ad-johnson/YAPS/README.md

# YAPS
Bench top power supply

Schematics are in the Design folder

Custom footprints and symbols are in the Kicad folder: these will need downloading and their location added into the Kicad project's preferences: add location to Manage Symbol Libraries and Manage Footprint Libraries

LTSpice files are in the LTSpice file.  They are broken down into three parts: Power Stage; Control Stage and Combined.  AndrewsParts may need to be put into your LTSpice installation sym library, e.g. ~/Library/ApplicationSupport/LTSpice/lib/sym
