ad-johnson/YAPS/Design/Other/BOM.xlsx

Name | Type | Ref - Control Stage | Ref - Power Stage | Reqd Qty | Order Qty | Mounting | Mfr | Mfr Part No. | Farnell Code | Digikey Code | CPC Code | Mouser Code | Datasheet | Notes
0.1uF | Capacitor | C2, C7 |  | 2 | 10 | 0805 | Multicomp | MC0805B104J500CT | 2320839 |  |  |  | Datasheet (http://www.farnell.com/datasheets/1901289.pdf)
100uF | Electrolytic | C1, C10 |  | 2 | 2 | 8x10 SMD | Nichicon | UUD1H101MNL1GS | 8823391 |  |  |  | Datasheet (http://www.farnell.com/datasheets/2100017.pdf)
6-way receptacle | CONNECTOR | J3, J6 |  | 2 | 2 | N/A | Molex | 22-01-2061 |  | WM1579-ND |  |  | Datasheet (https://www.molex.com/pdm_docs/sd/022012061_sd.pdf)
6-way header | CONNECTOR | J3, J6 |  | 2 | 2 | TH | Molex | 22-27-2061 |  | WM4115-ND |  |  | Datasheet (https://www.molex.com/pdm_docs/sd/022272061_sd.pdf)
2-way receptacle | CONNECTOR | J1 |  | 1 | 1 | N/A | Molex | 22-01-2021 |  | WM1575-ND |  |  | Datasheet (https://www.molex.com/pdm_docs/sd/022012021_sd.pdf)
2-way header | CONNECTOR | J1 |  | 1 | 1 | TH | Molex | 22-27-2021 |  | WM4111-ND |  |  | Datasheet (https://www.molex.com/pdm_docs/sd/022272021_sd.pdf)
8-way receptacle | CONNECTOR | J4 |  | 1 | 1 | N/A | Molex | 22-01-2081 |  | WM1581-ND |  |  | Datasheet (https://www.molex.com/pdm_docs/sd/022012081_sd.pdf)
8-way header | CONNECTOR | J4 |  | 1 | 1 | TH | Molex | 22-27-2081 |  | WM4117-ND |  |  | Datasheet (https://www.molex.com/pdm_docs/sd/022272081_sd.pdf)
Crimp | CONNECTOR | J1, J3, J4, J6 |  | 4 | 25 | N/A | Molex | 08-50-0032 |  | WM2623-ND |  |  | Datasheet (https://www.molex.com/pdm_docs/ps/PS-99020-0088.pdf)
Current Source LT3092 | IC | U2 |  | 1 | 1 | SOT223 | Linear Technology | LT3092EST#TRPBF |  | LT3092EST#TRPBFCT-ND |  |  | Datasheet (http://www.linear.com/docs/27892)
Step Down Reg LTC1624 | IC | U1 |  | 1 | 1 | 8-SOIC | Linear Technology | LTC1624CS8#PBF |  | LTC1624CS8#PBF-ND |  |  | Datasheet (http://www.linear.com/docs/3645)
Linear Reg LT3081 | IC | U3, U4 |  | 2 | 2 | TO-220-7 | Linear Technology | LT3081ET7#PBF |  | LT3081ET7#PBF-ND |  |  | Datasheet (http://www.linear.com/docs/43256)
Switched Inv LTC1983-2 | IC | U5 |  | 1 | 1 | SOT226 | Linear Technology | LTC1983ES6-3#TRPBF |  | LTC1983ES6-3#TRPBFCT-ND |  |  | Datasheet (http://www.linear.com/docs/2135)
Pwr/Curr Monitor INA260 | IC | U6 |  | 1 | 1 | 16-TSSOP | TI | INA260AIPWR |  | 296-47777-1-ND |  |  | Datasheet (http://www.ti.com/general/docs/suppproductinfo.tsp?distId=10)
DC-DC Linear Converter 5V 1A | REGULATOR | U7 |  | 1 | 1 | SIP/TO-220 | Traco Power | TSRN 1-2450 | 2280247 |  |  |  | Datasheet (https://docs-emea.rs-online.com/webdocs/16ed/0900766b816ed3dd.pdf) | TSR 1-2450 also acceptable
470pF | Capacitor | C3 |  | 1 | 10 | 0805 | Vishay | VJ0805Y471JXAPW1BC | 2896583 |  |  |  | Datasheet (http://www.farnell.com/datasheets/2620235.pdf)
100pF | Capacitor | C4 |  | 1 | 10 | 0805 | Kemet | C0805C101J5RACAUTO | 2905173 |  |  |  | Datasheet (http://www.farnell.com/datasheets/2750056.pdf)
1000pF | Capacitor | C6, C8, C9 |  | 3 | 10 | 0805 | Multicomp | MC0805B102J500CT | 2320837 |  |  |  | Datasheet (http://www.farnell.com/datasheets/1901289.pdf)
10uF | Capacitor | C11, C12, C13, C14, C15, C17, C18, C19, C20, C21, C22, C23, C25 |  | 13 | 20 | 0805 | Murata | GRM21BR6YA106KE43L | 2611943 |  |  |  | Datasheet (http://www.farnell.com/datasheets/2079187.pdf)
1uF | Capacitor | C24, C26 |  | 2 | 5 | 0805 | Murata | GCM21BR71H105KA03L | 2688485 |  |  |  | Datasheet (http://www.farnell.com/datasheets/2189091.pdf)
6K8 | Resistor | R1 |  | 1 | 10 | 0805 | Multicomp | MCWR08X6801FTL | 2447711 |  |  |  | Datasheet (http://www.farnell.com/datasheets/2563624.pdf)
10m | Resistor | R2 |  | 1 | 5 | 0805 | Samsung | RU2012FR010CS |  | 1276-6156-1-ND |  |  | Datasheet (http://www.samsungsem.com/kr/support/product-search/chip-resistor/RU2012FR010CS.jsp)
1K | Resistor | R3, R10, R11 |  | 3 | 10 | 0805 | Multicomp | MCWR08X1001FTL | 2447587 |  |  |  | Datasheet (http://www.farnell.com/datasheets/2563624.pdf)
5K | Resistor | R4 |  | 1 | 10 | 0805 | Vishay | CRCW08055K00FKTA | 2616759 |  |  |  | Datasheet (http://www.farnell.com/datasheets/2310790.pdf)
100K | Resistor | R5, R6 |  | 2 | 10 | 0805 | Multicomp | MCWR08X1003FTL | 2447551 |  |  |  | Datasheet (http://www.farnell.com/datasheets/2563624.pdf)
200 | Resistor | R7 |  | 1 | 10 | 0805 | Multicomp | MCWR08X2000FTL | 2447602 |  |  |  | Datasheet (http://www.farnell.com/datasheets/2563624.pdf)
47K5 | Resistor | R8 |  | 1 | 10 | 0805 | Multicomp | MCWR08X4752FTL | 2447665 |  |  |  | Datasheet (http://www.farnell.com/datasheets/2563624.pdf)
73K2 | Resistor | R9 |  | 1 | 10 | 0805 | Panasonic | ERJ6ENF7322V | 2303742 |  |  |  | Datasheet (http://www.farnell.com/datasheets/1911175.pdf)
1K 1% | Resistor | - |  |  | 0 | 0805 |  |  |  |  |  |  | Datasheet (http://www.farnell.com/datasheets/2563624.pdf) | See 1K resistor which is 1%
10K 1% | Resistor | R12, R13, R16, R17, R23, R24, R25 |  | 7 | 10 | 0805 | Multicomp | MCWF08P1002FTL | 2694096 |  |  |  | Datasheet (http://www.farnell.com/datasheets/2189453.pdf)
3K3 | Resistor | R14 |  | 1 | 10 | 0805 | Vishay | CRCW08053K30FKEA | 1469911 |  |  |  | Datasheet (http://www.farnell.com/datasheets/2310790.pdf)
100 | Resistor | R15 |  | 1 | 10 | 0805 | Multicomp | MCWR08X1000FTL | 2447552 |  |  |  | Datasheet (http://www.farnell.com/datasheets/2563624.pdf)
10K | Resistor | - |  |  | 0 | 0805 |  |  |  |  |  |  | Datasheet | See 10K resistor which is 1%
15m 1% | Resistor | R18, R19 |  | 2 | 5 | 0805 | Panasonic | ERJ-6CWFR015V |  | P19200CT-ND |  |  | Datasheet (https://industrial.panasonic.com/cdbs/www-data/pdf/RDN0000/AOA0000C313.pdf)
220 | Resistor | R20 |  | 1 | 10 | 0805 | Multicomp | MCWR08X2200FTL | 2447606 |  |  |  | Datasheet (http://www.farnell.com/datasheets/2563624.pdf)
2K2 | Resistor | R21, R22 |  | 2 | 10 | 0805 | Multicomp | MCWR08X2201FTL | 2447623 |  |  |  | Datasheet (http://www.farnell.com/datasheets/2563624.pdf)
Schottky Rectifier | RECTIFIER | D1, D2 |  | 2 | 5 | SMC - 2 Lead | ON Semiconductor | MBRS340T3G | 9557377 |  |  |  | Datasheet (http://www.farnell.com/datasheets/2353896.pdf)
NPN Mosfet | MOSFET | Q1 |  | 1 | 5 | TO-220 | Infineon | IRF3205PBF | 1704017 |  |  |  | Datasheet (http://www.farnell.com/datasheets/2043115.pdf)
2N3906 PNP Bipolar | TRANSISTOR | Q2 |  | 1 | 5 | TO-92 | On Semiconductor | 2N3906TA | 2453753 |  |  |  | Datasheet (https://www.onsemi.com/pub/Collateral/2N3906-D.PDF)
10uH Inductor | INDUCTOR | L1 |  | 1 | 1 | SMD Lead Frame | Bourns | SRP1265A-100M | 2434072 |  |  |  | Datasheet (http://www.farnell.com/datasheets/2366823.pdf)
2N3904 NPN Bipolar | TRANSISTOR | Q3 |  | 1 | 5 | TO-92 | On Semiconductor | 2N3904BU | 1700648 |  |  |  | Datasheet (http://www.farnell.com/datasheets/2284140.pdf)
10000pF | Capacitor | C16 |  | 1 | 10 | 0805 | Multicomp | MCU0805R103KCT | 9406352 |  |  |  | Datasheet (http://www.farnell.com/datasheets/1859359.pdf)
10K 10 Turn Potentiometer | POTENTIOMETER | Enclosure |  | 1 | 1 | Panel | Bourns | 3590S-1-103L |  | 3590S-1-103L-ND |  |  | Datasheet (https://www.bourns.com/docs/Product-Datasheets/3590.pdf)
5K 10 Turn Potentiometer | POTENTIOMETER | Enclosure |  | 1 | 1 | Panel | Bourns | 3590S-1-502L |  | 3590S-1-502L-ND |  |  | Datasheet (https://www.bourns.com/docs/Product-Datasheets/3590.pdf)
Rotary Dial | KNOB | Enclosure |  | 2 | 2 | N/A | Bourns | HH-516-6A |  | HH-516-6A-ND |  |  | Datasheet (https://www.bourns.com/docs/Product-Datasheets/H-516.pdf)
Red Binding Post | CONNECTOR | Enclosure |  | 1 | 1 | Panel | Cliff Electronic Components | TP1 Red | 1815818 |  |  |  | Datasheet (http://www.farnell.com/datasheets/1712124.pdf)
Black Binding Post | CONNECTOR | Enclosure |  | 1 | 1 | Panel | Cliff Electronic Components | TP1 Black | 1815819 |  |  |  | Datasheet (http://www.farnell.com/datasheets/1712124.pdf)
10R 100W Power Resistor | Resistor | OPTIONAL FOR TESTING |  | 0 | 1 | N/A | CGS-TE Connectivity | HSC10010RJ |  |  | RE03534 |  | Datasheet (http://www.farnell.com/datasheets/463742.pdf)
SPDT Switch | SPDT | Enclosure |  | 1 | 1 | Panel | E-Switch | RR3130CBLKBLKFS |  | EG1891-ND |  |  | Datasheet (https://www.e-switch.com/system/asset/product_line/data_sheet/94/RR3130.pdf)
60VA 9-0-9 3.3A | TRANSFORMER |  | Enclosure | 1 | 1 | Panel | Multicomp | MCTA060/09 |  |  | FF01551 |  | Datasheet (http://www.farnell.com/datasheets/1945759.pdf)
Terminal Block, 2-way | CONNECTOR | J2, J5 | J1, J2 | 4 | 4 |  | Phoenix Contact | 1729128 |  |  | CN14697 |  | Datasheet (http://www.farnell.com/datasheets/2793337.pdf)
Bridge Rectifier | RECTIFIER |  | D1 | 1 | 1 | TH | Taiwan Semiconductor | GBU603 |  |  | SC09284 |  | Datasheet (http://www.farnell.com/datasheets/41665.pdf)
Smoothing Capacitor | Capacitor |  | C1, C2 | 2 | 2 | TH | Multicomp | LPR50V478M30X25 |  |  | CA04834 |  | Datasheet (http://www.farnell.com/datasheets/1441585.pdf)
Bleed Resistor | Resistor |  | R1 | 1 | 10 | TH | TT Electronics | MFP1-10K JI |  |  | RE05119 |  | Datasheet (http://www.farnell.com/datasheets/40613.pdf)
Slow blow Fuse | FUSE |  | Enclosure | 1 | 10 | N/A | Littelfuse | 021502.5P |  |  | FF02710 |  | Datasheet (http://www.farnell.com/datasheets/2290195.pdf)
Switch&plug | CONNECTOR |  | Enclosure | 1 | 1 | Panel | Bulgin | BZH01/Z0000/01 |  |  | CN01731 |  | Datasheet
Mains plug&lead | CONNECTOR |  | Enclosure | 1 | 1 | N/A | Pro Elect | PE01086 |  |  | PL13317 |  | Datasheet (https://www.screwfix.com/p/uk-plug-to-iec-cable-2m/68085?_requestid=402455)
Thermal Paste | HEATSINK | Consumable |  | 1 | 1 | N/A | Servisol | 200001000 25GM |  |  | SAHEATSINKCOMP |  | Datasheet (http://www.farnell.com/datasheets/1792677.pdf)
Insulating Bushes | HEATSINK | Consumable |  | 3 | 10 | N/A | Unbranded | 31-35-25GFN |  |  | SC01134 |  | Datasheet (http://www.farnell.com/datasheets/1845954.pdf)
Mounting screws | HEATSINK | Consumable |  | 3 | 15 | M3 | Multicomp | MK3311 | 520160 |  |  |  | Datasheet (http://www.farnell.com/datasheets/1692760.pdf)
TO220 Heatsink | HEATSINK | U3, U4 |  | 2 | 2 | TO-220 | FischerElektronik | FK 214 SA-CB |  |  | SC10835 |  | Datasheet (http://www.farnell.com/datasheets/17590.pdf) | For LT3081, 15 c/w
TO220 heatsink | HEATSINK |  | D1 | 1 | 1 | N/A | Aavid Thermalloy | 1.25GY-50 |  |  | SC10807 |  |  | For GBU603, 8.6c/w. Needs adjusting as it has a groove for TO220 in the middle. Perhaps look for a more suitable one?
PCB Mounts | MOUNT | Enclosure |  | 8 | 10 | N/A | Duratool | D01468 |  |  | PC01634 |  | Datasheet (http://www.farnell.com/datasheets/1900466.pdf)
Ring crimp terminals | MOUNT |  | Enclosure | 1 | 10 | M3 | JST | LRB-2.5TM3 |  |  | CN16906 |  | Datasheet (http://www.farnell.com/datasheets/47297.pdf)
10K Thermistor | THERMISTOR | J6 |  | 3 | 3 | TH | Ametherm | PANE 103395-410 |  | 570-1065-ND |  |  | Datasheet (https://media.digikey.com/pdf/Data%20Sheets/Ametherm%20PDFs/PANE_103395-410_Spec.pdf)
4Duino | Micro + LED | Enclosure |  | 1 | 1 | N/A | 4D systems | SK-4Duino-24 |  |  |  | 971-SK-4DUINO-24 | Datasheet (https://www.mouser.co.uk/datasheet/2/451/4Duino-24_datasheet_R_1_2-968583.pdf) | Starter kit. Could use a Leonardo and separate LCD. Design uses all 6 Analog in pins PLUS I2C pins
Assumes that transformer is being used for Power Stage. If a different supply is being used, then the items marked 'Enclosure' in Ref-Power Stage may not be required.
Heatshrink tubing should be considered for Power Stage connections; also wire connector blocks for ease of maintenance.
