ad-johnson/YAPS/Design/Other/Calculations.xlsx

Sheet: Fuse Calcs
Transformer VA | 60 | VA | Multicomp MCTA060/09
Transformer DC Resistance | 38 | Ohms | From datasheet 2x19Ohms
Efficiency | 88 | %
Vac | 240 | V
Max current | 3 | A
Ambient temperature | 25 | C
In-Rush current | 74 | A | Measured in LTSpice
 | 4.4 | ms | Duration of fall from peak
 | 5.4 | ms | duration of rise/fall
I^2t | 12.047 | A^2s | Common curve calculation: 0.5*I*I*duration of fall from peak
I^2t | 14.785 | A^2s | Curve calculation: 0.5*I*I*duration of rise/fall
LOAD SIDE |  |  | Calculated for interest, load side fuse not in design. Littelfuse 215 series
Fuse required | 4.05 | A | Max Current * 135%
Re-rating | 4.86 | A | Rerated for ambient 65C, 10% for 20C rise
Type | Slow-blow |  | For dealing with inrush current
Interrupt Rating | HIGH | kA
LINE SIDE |  |  | Littelfuse 215 series
Fuse Required | 0.329 | A | VA/Vac*(1/(1-2*(efficiency/100)))
Re-rating | 0.395 | A | Rerated for ambient 65C, 10% for 20C rise
Nearest Value | 0.4 | A
Re-rated for melting integral | 2.5 | A
Type | Slow-blow |  | For dealing with inrush current
Interrupt Rating | HIGH | kA | Fuse is mains supply side

Sheet: Capacitor Calcs
Current | 3 | A
Acceptable Peak-to-Peak ripple voltage | 1 | V
Time, 50Hz | 10 | ms | Full wave rectifier
Capacitance | 0.03 | F | C=IT/V
 | 30000 | uF
 | This seems a lot although, with 2 x 4700uF, LTSpice is given ripple of circa 2V at full load so it seems right
 | The choice of P-to-P acceptable is 'arbitrary' - there are no specs on the LT1624 to state what is an acceptable range.
 | The simulation works with a 2V ripple so start with that and if it causes an issue in the build then change to 2x15000 uF

Sheet: Thermistor Calcs
Using a simple voltage divider circuit to feed the monitor (attached to Vout)
Thermistor | 10000 | Ohms | at 25c
R2 | 10000 | Ohms
Vin | 5 | V
Vout | 2.5 | V | at Voltage Divider
I | 0.00025 | A
Pout | 0.000625 | W
Thermistor | 688 | Ohms | at 100c
R2 | 10000 | Ohms
Vin | 5 | V
Vout | 4.678143713 | V | at Voltage Divider
I | 0.0004678143713 | A
Pout | 0.00218850286 | W
Thermistor | 196 | Ohms | at 150c
R2 | 10000 | Ohms
Vin | 5 | V
Vout | 4.903883876 | V | at Voltage Divider
I | 0.0004903883876 | A
Pout | 0.002404807707 | W
 |  |  | Given the Pout values, choice of Thermistor is unlikely to be impacted
 |  |  | by its dissipation constant affecting accuracy

Sheet: Heat Calcs
 |  |  |  |  |  |  |  |  | Scenario 1 | Scenario 2 | Scenario 3 | Scenario 4 | Scenario 5
UA7805CKCT | TO-220 | 5V Regulator | Tjmax | Virtual Junction Temperature | 125 | C |  | Vin | 23.80 | 23.80 | 23.80 | 23.80 | 23.80
 |  |  | Rja | Junction-to-Ambient Resistance | 19 | C/W |  | Vout | 5.03 | 5.06 | 5.06 | 5.06 | 5.06
 |  |  | Rjc | Junction-to-Case Resistance | 3 | C/W |  | I | 0.235 | 0.235 | 0.235 | 0.235 | 0.235
 |  |  |  |  |  |  |  | Wdiss | 4.412 | 4.404 | 4.404 | 4.404 | 4.404
 |  |  |  |  |  |  | No Heatsink | Temp with Rja | 108.83 | 108.67 | 108.67 | 108.67 | 108.67
 |  |  |  |  |  |  | Heatsink 1 | Temp with Rjc, Rha | 152.95 | 152.71 | 152.71 | 152.71 | 152.71
 |  |  |  |  |  |  | Heatsink 2 | Temp with Rjc, Rha | 130.89 | 130.69 | 130.69 | 130.69 | 130.69
 |  |  |  |  |  |  | Heatsink 3 | Temp with Rjc, Rha | 104.42 | 104.27 | 104.27 | 104.27 | 104.27
 |  |  |  |  |  |  | Heatsink 4 | Temp with Rjc, Rha | 76.18 | 76.09 | 76.09 | 76.09 | 76.09
 |  |  |  |  |  |  | Heatsink 5 | Temp with Rjc, Rha | 83.28 | 83.18 | 83.18 | 83.18 | 83.18
 |  |  |  |  |  |  |  |  | LM7805 isn't going to work. Need to use a DC-DC linear converter
 |  |  |  |  |  |  |  |  | Available in a LM7805 footprint. Won't need a heatsink.
LT3092 | SOT223 | Current Source | Tjmax | Junction Temperature | 125 | C |  |  | Scenario 1 | Scenario 2 | Scenario 3 | Scenario 4 | Scenario 5
 |  |  | Rja | Junction-to-Ambient Resistance | 24 | C/W |  | Vin | 23.80 | 23.80 | 23.80 | 23.80 | 23.80
 |  |  | Rjc | Junction-to-Case Resistance | 15 | C/W |  | Vout | 1.40 | 15.32 | 15.32 | 15.32 | 1.28
 |  |  |  |  |  |  |  | I | 0.001 | 0.001 | 0.001 | 0.001 | 0.001
 |  |  |  |  |  |  |  | Wdiss | 0.03 | 0.01 | 0.01 | 0.01 | 0.03
 |  |  |  |  |  |  | No Heatsink | Temp with Rja | 25.75 | 25.28 | 25.28 | 25.28 | 25.76
 |  |  |  |  |  |  |  |  | Scenario 1 | Scenario 2 | Scenario 3 | Scenario 4 | Scenario 5
LT3081 | TO-220 | Linear Regulator | Tjmax | Junction Temperature | 150 | C |  | Vin | 2.93 | 16.21 | 15.72 | 17.18 | 2.90
 |  |  | Rja | Junction-to-Ambient Resistance | 40 | C/W |  | Vout | 1.04 | 15.19 | 15.47 | 15.38 | 1.00
 |  |  | Rjc | Junction-to-Case Resistance | 3 | C/W |  | I | 1.53 | 1.47 | 0.26 | 0.78 | 0.26
 |  |  |  |  |  |  |  | Wdiss | 2.89 | 1.50 | 0.07 | 1.41 | 0.49
 |  |  |  |  |  |  | No Heatsink | Temp with Rja | 140.67 | 84.98 | 27.60 | 81.38 | 44.46
 |  |  |  |  |  |  | Heatsink 1 | Temp with Rjc, Rha | 108.86 | 68.48 | 26.89 | 65.87 | 39.11
 |  |  |  |  |  |  | Heatsink 2 | Temp with Rjc, Rha | 94.40 | 60.99 | 26.56 | 58.83 | 36.67
 |  |  |  |  |  |  | Heatsink 3 | Temp with Rjc, Rha | 77.05 | 51.99 | 26.17 | 50.37 | 33.76
 |  |  |  |  |  |  | Heatsink 4 | Temp with Rjc, Rha | 58.54 | 42.39 | 25.75 | 41.35 | 30.64
 |  |  |  |  |  |  |  |  | Full load |  |  | Calculated from info in datasheet for LT1624
IRF3205PBF | TO-220 | NPN Mosfet | Tjmax | Junction Temperature | 175 | C |  | Vout | 15.00 |  |  |  | 0.6326530612 | Main switch duty cycle
 |  |  | Rja | Junction-to-Ambient Resistance | 62 | C/W |  | Imax | 3.00 |  |  |  | 9 | I^2
 |  |  | Rjc | Junction-to-Case Resistance | 0.75 | C/W |  |  |  |  |  |  | 0.009 | Temperature allowance
 |  |  | Rjs | Case-to-Sink, flat, greased Resistance | 0.5 | C/W |  | Pmain (see LTC1628 calcs) | 0.164 |  |  |  | 893.9861814 | Constant adjustment
 |  |  | Pdiss | 200W@25c / derating 1.3 C/W |  |  | No Heatsink | Temp with Rja | 35.19 |  |  |  | 0.0001266 | Frequency allowance
 |  |  | Rds(on) |  | 0.008 | Ohms | Heatsink 1 | Temp with Rjc, Rha, Rjs | 29.48
 |  |  | Crss |  | 2.11e-10 | F | Heatsink 2 | Temp with Rjc, Rha, Rjs | 28.66 |  |  | Full load= | ((Vout +Vd) / (Vin + Vd)) * Imax^2 * ((1+(theta * Temp rise)) * Rds(on)) +
 |  |  | Frequency |  | 200000 | Hz | Heatsink 3 | Temp with Rjc, Rha, Rjs | 27.67 |  |  |  | (K * (Vin ^ 1.85)) * Imax * Crss * Frequency
 |  |  | Vin |  | 24 | V | Heatsink 4 | Temp with Rjc, Rha, Rjs | 26.62 |  |  |  | OR
 |  |  | Vd | Shottky Diode forward voltage | 0.5 | V | Heatsink 5 | Temp with Rjc, Rha, Rjs | 26.88 |  |  |  | Main switch duty cycle * I^2 * temperature allowance +
 |  |  | Temp rise | 50C - ambient | 25 | C |  |  |  |  |  |  | Constant adjustment *Frequency Allowance
 |  |  | K | Constant | 2.5
 |  |  | T | Temperature adjustment | 0.005
 |  |  |  |  |  |  |  |  | Short Circuit |  |  | Short Circuit= Imax * (Vd * (Vin / (Vin + Vd)))
MBRS340T3G | SMC | Shottky Diode | iMax | Max current | 3 | A |  | Vin | 24
 |  |  | Vd | Forward Voltage | 0.5 | V |  | Wdiss | 1.469
 |  |  | Vin |  | 24 | V | No Heatsink | Temp with Rjl | 41.163
 |  |  | Rjl | Junction to lead | 11 | C/W
 |  |  | Tjmax | Junction Temperature | 150 | C
 |  |  |  |  |  |  |  |  | Scenario 1 | Scenario 2 | Scenario 3 | Scenario 4 | Scenario 5
GBU603 | SIP | Bridge Rectifier | Tjmax | Junction Temperature | 150 | C |  | I | 3 | 3 | 0.5 | 1.5 | 0.5
 |  |  | Rja* | Junction-to-Ambient Resistance | 7 | C/W |  | Wdiss | 5.4 | 5.4 | 0.9 | 2.7 | 0.9
 |  |  | Rjc* | Junction-to-Case Resistance | 2 | C/W | No Heatsink | Temp with Rja
 |  |  | Vfwd | Forward Voltage | 0.9 | V/diode | Heatsink 1 | Temp with Rjc
 |  |  | * When mounted on AL heat sink 6.5x3.5x0.15cm |  |  |  | Heatsink 2 | Temp with Rha
 |  |  |  |  |  |  | Heatsink 3 | Temp with Rha
Ambient, C: | 25 |  |  |  |  |  | Heatsink 4 | Temp with Rha | 82.24 | 82.24 | 34.54 | 53.62 | 34.54
Scenario 1: Load pulling 3A at 1V, 0.333Ohms
Scenario 2: Load pulling 3A at 15V, 5Ohms |  |  |  |  |  |  | Need to take a different approach with this one as the specs are quoted with
Scenario 3: Load pulling 0.5A at 15V, 30Ohms |  |  |  |  |  |  | heatsink already in place. 5.4W is a lot to dissipate therefore we want a
Measured with LTSpice for LT3081 and UA7805CKCT |  |  |  |  |  |  | heatsink at least as good as Heatsink4 and then measure in-situ to confirm
Heatsink 1, Rha | 26
Heatsink 2, Rha | 21
Heatsink 3, Rha | 15
Heatsink 4, Rha | 8.6
Heatsink 5, Rha | 10.21
Scenario 4: Load pulling 1.5A at 15V, 10Ohms
Scenario 5: Load pulling 0.5A at 1V, 2Ohms

Sheet: LTC1624 Calcs
From datasheet
Rsense selection |  | Page 7
Imax | 3 | A
Rsense | 0.03333333333 | Ohms
Under LTSpice simulation, raising Rsense to this value results in unstable output. Stick with 0.01Ohms and test
Inductor Value |  | Page 7 |  |  | Assumed Inductor |  | Delta-IL
Vin | 24 | V |  | L | 5 | uH | 5.69
Vout | 15 | V |  | L | 10 | uH | 2.85
f | 200000 | Hz |  | L | 15 | uH | 1.90
Vd | 0.5 | V | Schottky diode forward drop | L | 20 | uH | 1.42
 |  |  |  | L | 50 | uH | 0.57
Select FERRITE core. Be aware of peak design current for selection.
Power MOSFET selection |  | Page 8
Vin | 24 | V
Vout | 15 | V
Vd | 0.5 | V | Typical Schottky Diode forward voltage
Main Switch Duty Cycle | 0.633 | V
iMax | 3 | A
Temp Dependancy | 0.005 | /C
Rds(on) | 0.008 | Ohms
K | 2.5
Crss | 2.11e-10 | F
f | 200000 | Hz
Temp rise | 25 | C | 50C - Ambient
Pmain | 0.164 | W
Need to deal with the power dissipation through heatsink - see Heat Calcs sheet
Schottky Diode |  | Page 8
Vin | 24 | V
Vd | 0.5 | V | Forward voltage drop to aim for
Isc | 3 | A
Short Circuit dissipation | 1.469 | W
Need a low thermal resistance
Cin and Cout |  | Page 8
Imax | 3 | A
Vin | 24 | V
Vout | 15 | V
Irms | 1.452 | A
Delta Il | 2.85 | A | 10uH - see inductor value | LTSpice simulation shows 10uH gives best characteristics although there's not much difference between 10uH and 50uH.
ESR | 0.03 | Ohms | resistance to aim for
Voutripple | 0.085 | V | simplified formula from page 13
Look for Cout capacitor with 0.03ohm ESR
Look for Cin capacitor that handles 1.452A RMS
INTVcc Regulator |  | Page 9
Ambient | 100 | C
Vin | 24 | V
Temp co-efficient | 110 | C/W
Supply current | 0.008 | A | From LTSpice simulation, current at Vin
Tj | 121.12 | C | With a max 100C ambient temperature
Needs monitoring under test.
