ad-johnson/YAPS/Spice Model/PowerStage.asc

C1: cap; 15000µ; V=472MRH mfg="   ---" pn="   ---" type="   ---"
C2: cap; 15000µ; V=472MRH mfg="   ---" pn="   ---" type="   ---"
D1: diode; MURS320
D2: diode; MURS320
D3: diode; MURS320
D4: diode; MURS320
Lpri: ind2; 10000µ
Lsec1: ind2; 14.062µ
Lsec2: ind2; 14.062µ
Rload: res; 100
V1: voltage; SINE(0 339.4113 50); Rser=.0001
Named nets: 0, Vin, Vsec, Vout
.tran 0 .1 startup
K Lpri Lsec1 Lsec2 1
240V/50Hz RMS AC source 
- peak is used (240*1.414)
Lpri is primary side of transformer.  
Choice of inductance is fairly arbitrary.
What is important is the RATIO between
primary and secondary
Need at least 20V @ 3A at Vout.  60VAC transformer.
9-0-9 secondary tapped transformer would give 18V RMS in series
(CPC has a 2x9v 3.33A)
with a peak of 18*1.414 peak-to-peak.
Estimate after rectification: (18v*1.414) - (2 * 0.7v) = 24.052V
Secondary inductance calculated from:
number of turns ratio between Vin peak-to-peak 
and 9V peak to peak
So: (240*1.414) / (9V *1.414) = 26.6667
Inductance of secondary = 10000/26.6667^2 = 14.062
Vout has average 23.262V 
and RMS of 23.437V
(to compare against estimated 24.052V)
Capacitor sizing:
C= I / (2 x f x Vpp)
C= 3 / (2 x 50 x 2)
C= 0.015 = 15000uF
