ad-johnson/YAPS/Design/ControlStage/PowerSupply.kicad_pcb

## KiCad design Design/ControlStage/PowerSupply.kicad_pcb (2019-06-09)

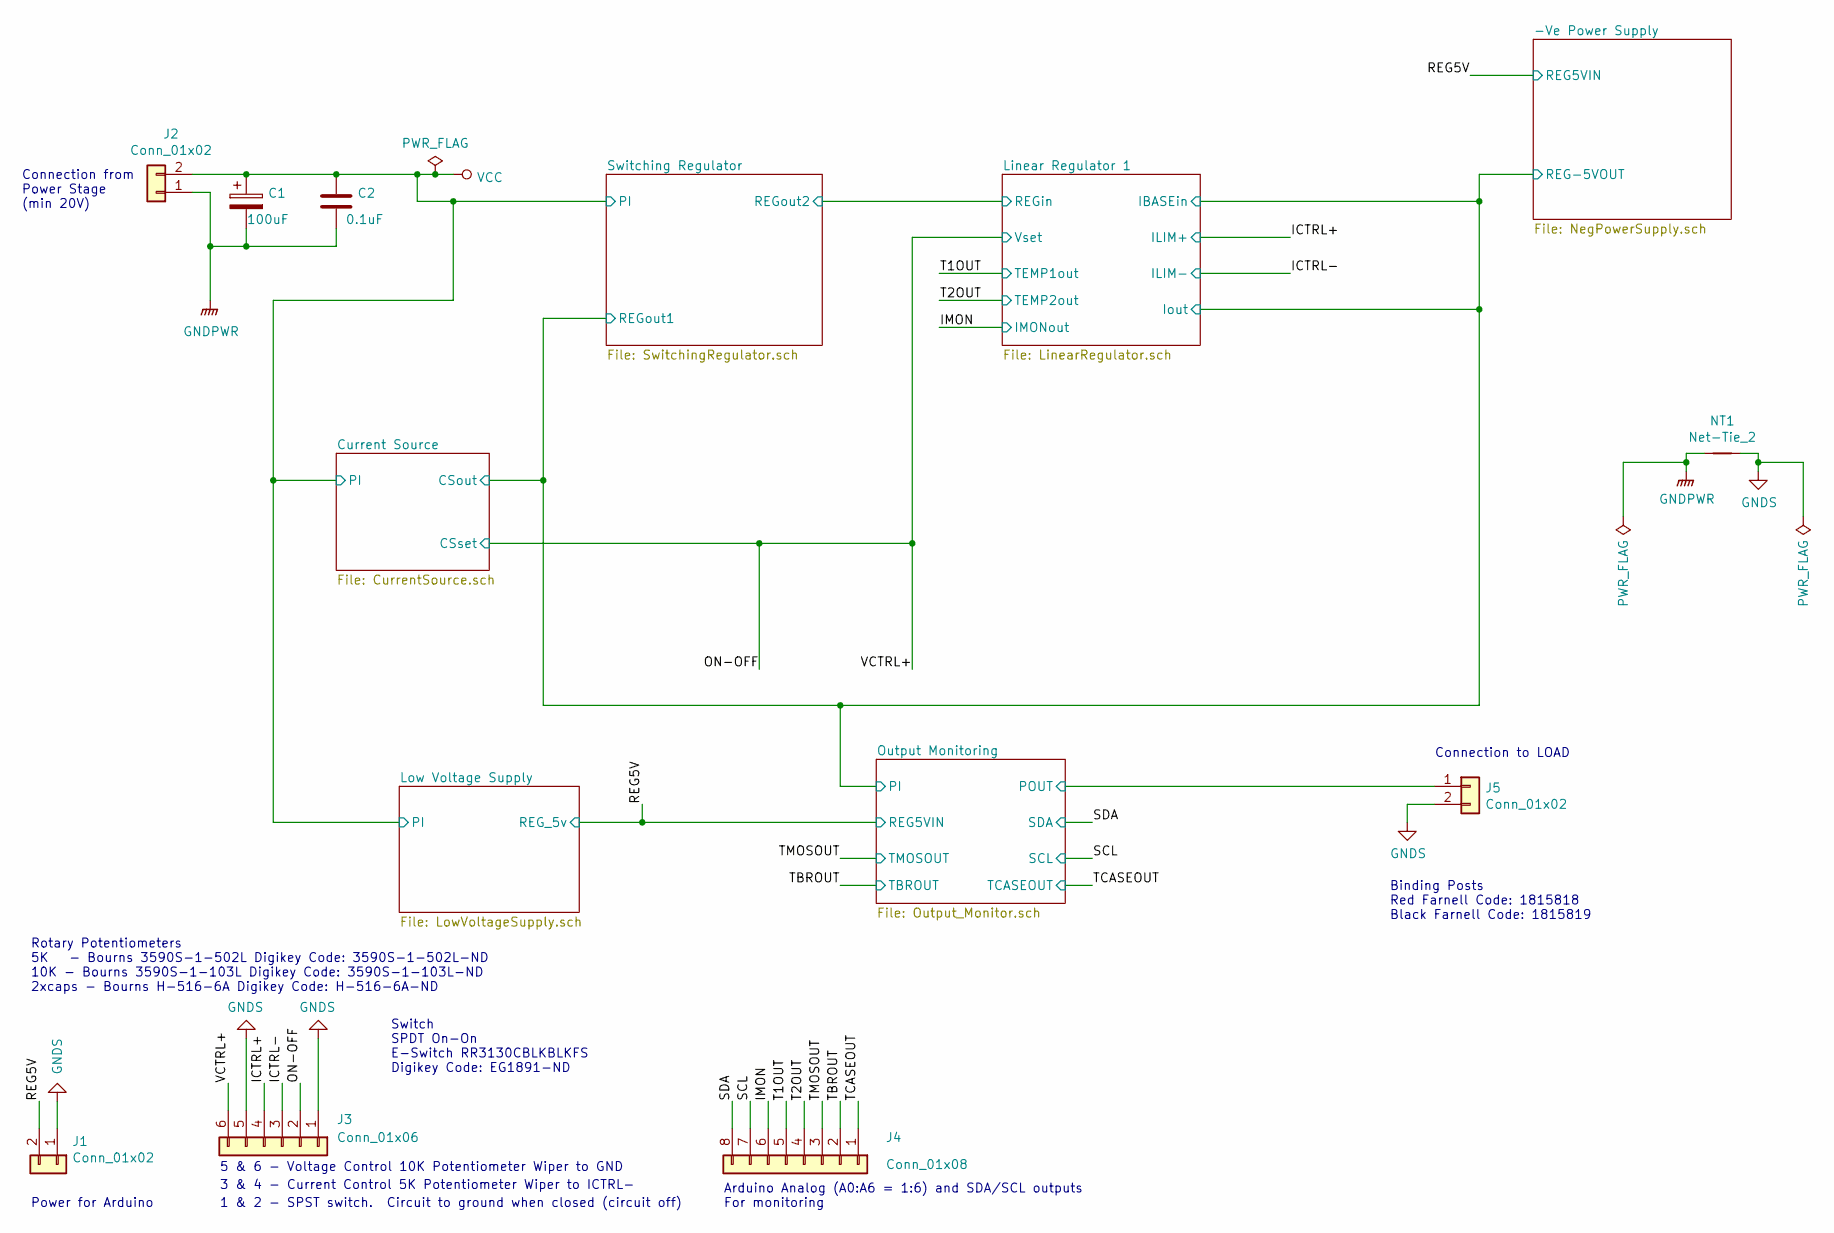
[picture p1: schematic PowerSupply.sch, YAPS - Regulated Power Supply]

Parts:
C1: 100uF; CP_Elec_8x10; Farnell Code 8823391
C2: 0.1uF; R_0805_2012Metric_Pad1.15x1.40mm_HandSolder; Farnell Code 2320839
J1: Conn_01x02; Molex_KK-254_AE-6410-02A_1x02_P2.54mm_Vertical; Digikey Code WM4111-ND + WM1575-ND + WM2623-ND
J2, J5: Conn_01x02; TerminalBlock_Phoenix_MKDS-1,5-2-5.08_1x02_P5.08mm_Horizont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
J3: Conn_01x06; Molex_KK-254_AE-6410-06A_1x06_P2.54mm_Vertical; Digikey Code WM4115-ND + WM1579-ND + WM2623-ND
J4: Conn_01x08; Molex_KK-254_AE-6410-08A_1x08_P2.54mm_Vertical; Digikey Code WM4117-ND + WM1581-ND + WM2623-ND
NT1: Net-Tie_2; NetTie-2_SMD_Pad2.0mm

Connections:
/ICTRL+: J3.4; also elsewhere on the board
/ICTRL-: J3.3; also elsewhere on the board
/IMON: J4.6; also elsewhere on the board
/ON-OFF: J3.2, J3.6; also elsewhere on the board
/Output Monitoring/POUT: J5.1; also elsewhere on the board
/REG5V: J1.2; also elsewhere on the board
/SCL: J4.7; also elsewhere on the board
/SDA: J4.8; also elsewhere on the board
/T1OUT: J4.5; also elsewhere on the board
/T2OUT: J4.4; also elsewhere on the board
/TBROUT: J4.2; also elsewhere on the board
/TCASEOUT: J4.1; also elsewhere on the board
/TMOSOUT: J4.3; also elsewhere on the board
GNDPWR: C1.2, C2.2, J2.1, NT1.1; also elsewhere on the board
GNDS: J1.1, J3.1, J3.5, J5.2, NT1.2; also elsewhere on the board
VCC: C1.1, C2.1, J2.2; also elsewhere on the board

Notes on the sheet:
Connection from Power Stage (min 20V)
5 & 6 - Voltage Control 10K Potentiometer Wiper to GND
Arduino Analog (A0:A6 = 1:6) and SDA/SCL outputs For monitoring
3 & 4 - Current Control 5K Potentiometer Wiper to ICTRL-
Connection to LOAD
1 & 2 - SPST switch. Circuit to ground when closed (circuit off)
Power for Arduino
Rotary Potentiometers 5K - Bourns 3590S-1-502L Digikey Code: 3590S-1-502L-ND 10K - Bourns 3590S-1-103L Digikey Code: 3590S-1-103L-ND 2xcaps - Bourns H-516-6A Digikey Code: H-516-6A-ND
Binding Posts Red Farnell Code: 1815818 Black Farnell Code: 1815819
Switch SPDT On-On E-Switch RR3130CBLKBLKFS Digikey Code: EG1891-ND

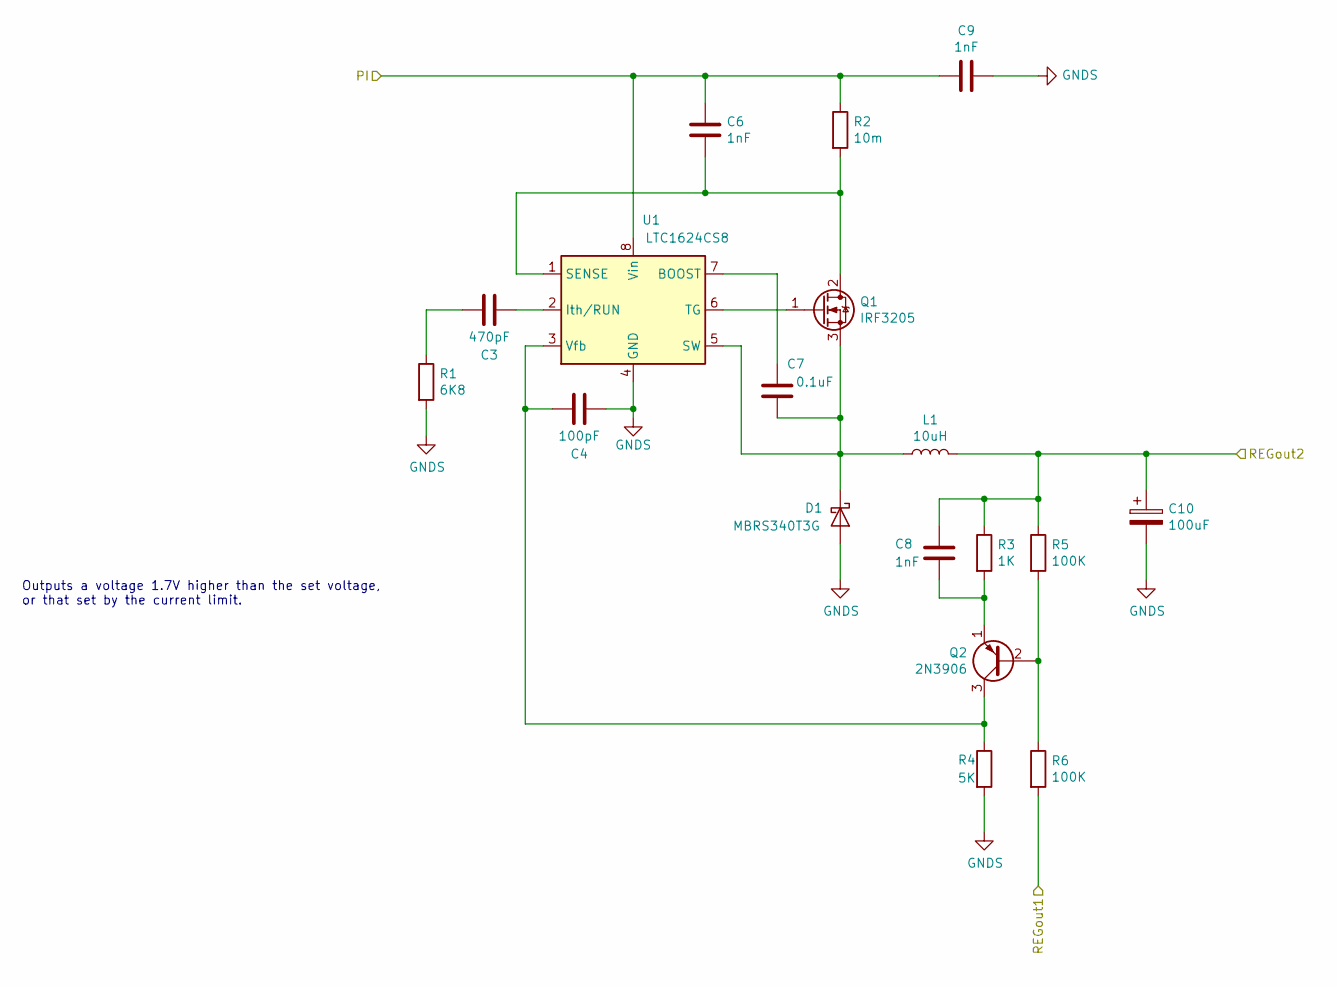
[picture p2: schematic SwitchingRegulator.sch, YAPS - Regulated Power Supply]

Parts:
C3: 470pF; C_0805_2012Metric_Pad1.15x1.40mm_HandSolder; Farnell Code 2896583
C4: 100pF; C_0805_2012Metric_Pad1.15x1.40mm_HandSolder; Farnell Code 2905173
C6, C8, C9: 1nF; C_0805_2012Metric_Pad1.15x1.40mm_HandSolder; Farnell Code 2320837
C7: 0.1uF; R_0805_2012Metric_Pad1.15x1.40mm_HandSolder; Farnell Code 2320839
C10: 100uF; CP_Elec_8x10; Farnell Code 8823391
D1: MBRS340T3G; D_SMC_Handsoldering; Farnell Code 9557377
L1: 10uH; L_Bourns_SRP1245A_Handsoldering; Farnell Code 2434072
Q1: IRF3205; TO-220-3_Vertical; Farnell Code 1704017
Q2: 2N3906; TO-92_Inline_Wide; Farnell Code 2453753
R1: 6K8; R_0805_2012Metric_Pad1.15x1.40mm_HandSolder; Farnell Code 2447711
R2: 10m; R_0805_2012Metric_Pad1.15x1.40mm_HandSolder; Digikey Code 1276-6156-1-ND
R3: 1K; R_0805_2012Metric_Pad1.15x1.40mm_HandSolder; Farnell Code 2447587
R4: 5K; R_0805_2012Metric_Pad1.15x1.40mm_HandSolder; Farnell Code 2616759
R5, R6: 100K; R_0805_2012Metric_Pad1.15x1.40mm_HandSolder; Farnell Code 2447551
U1: LTC1624CS8; SOIC-8_3.9x4.9mm_P1.27mm; Digikey Code LTC1624CS8#PBF-ND

Connections:
/Current Source/CSout: R6.2; also elsewhere on the board
/Linear Regulator 1/REGin: C8.1, C10.1, L1.2, R3.1, R5.1; also elsewhere on the board
GNDS: C4.1, C9.1, C10.2, D1.2 (A), R1.2, R4.2, U1.4 (GND); also elsewhere on the board
unnamed: C3.1, U1.2 (Ith/RUN)
unnamed: C3.2, R1.1
unnamed: C4.2, Q2.3 (C), R4.1, U1.3 (Vfb)
unnamed: C6.2, Q1.2 (D), R2.2, U1.1 (SENSE)
unnamed: C7.1, U1.7 (BOOST)
unnamed: C7.2, D1.1 (K), L1.1, Q1.3 (S), U1.5 (SW)
unnamed: C8.2, Q2.1 (E), R3.2
unnamed: Q1.1 (G), U1.6 (TG)
unnamed: Q2.2 (B), R5.2, R6.1
VCC: C6.1, C9.2, R2.1, U1.8 (Vin); also elsewhere on the board

Notes on the sheet:
Outputs a voltage 1.7V higher than the set voltage, or that set by the current limit.

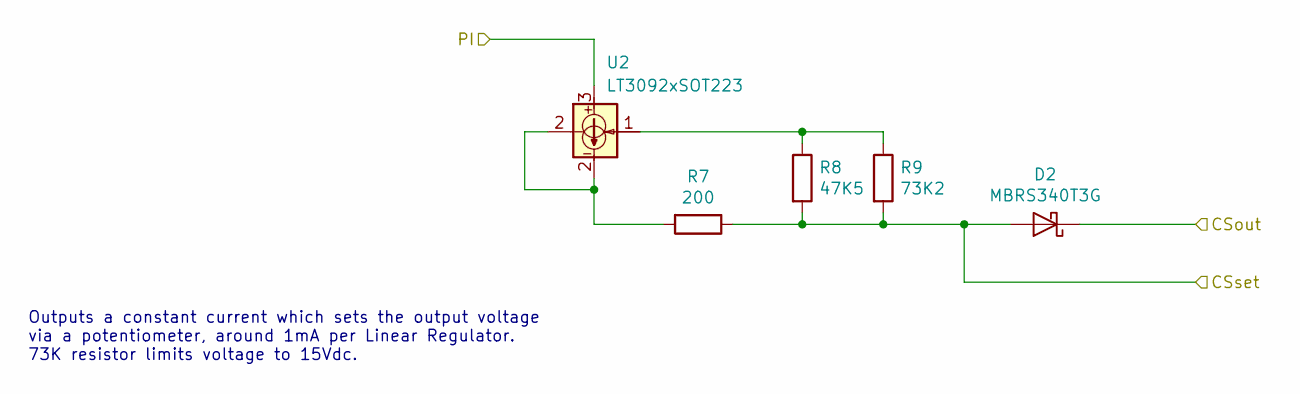
[picture p3: schematic CurrentSource.sch, YAPS - Regulated Power Supply]

Parts:
D2: MBRS340T3G; D_SMC_Handsoldering; Farnell Code 9557377
R7: 200; R_0805_2012Metric_Pad1.15x1.40mm_HandSolder; Farnell Code 2447602
R8: 47K5; R_0805_2012Metric_Pad1.15x1.40mm_HandSolder; Farnell Code 2447665
R9: 73K2; R_0805_2012Metric_Pad1.15x1.40mm_HandSolder; Farnell Code 2303742
U2: LT3092xSOT223; SOT-223-3_TabPin2; Digikey Code LT3092ETS8#TRPBFCT-ND

Connections:
/Current Source/CSout: D2.1 (K); also elsewhere on the board
/ON-OFF: D2.2 (A), R7.1, R8.2, R9.2; also elsewhere on the board
unnamed: R7.2, U2.2
unnamed: R8.1, R9.1, U2.1
VCC: U2.3; also elsewhere on the board

Notes on the sheet:
Outputs a constant current which sets the output voltage via a potentiometer, around 1mA per Linear Regulator. 73K resistor limits voltage to 15Vdc.

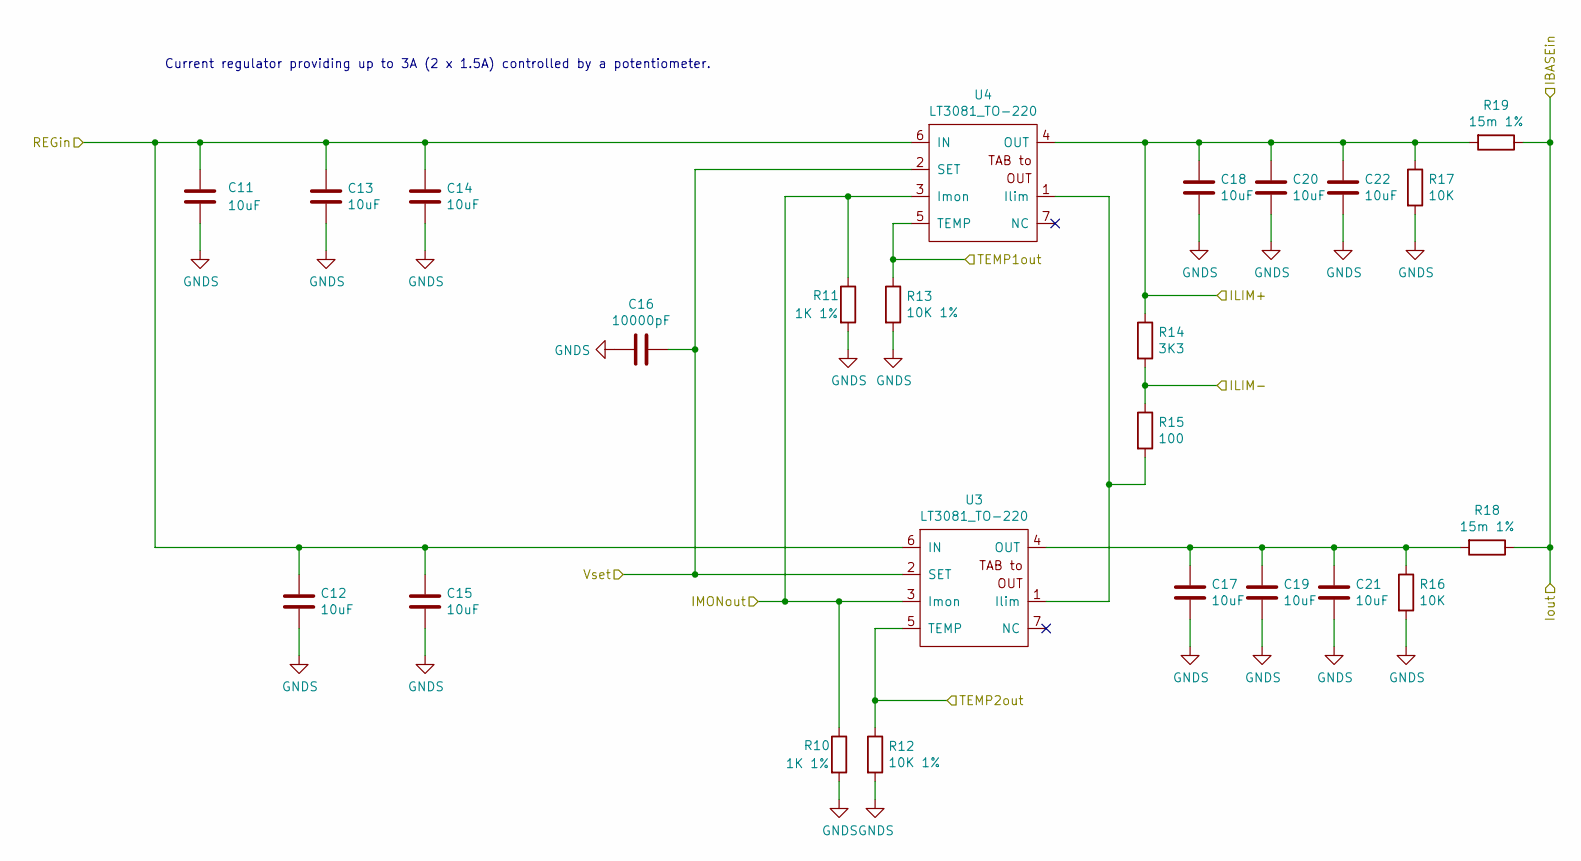
[picture p4: schematic LinearRegulator.sch, YAPS - Regulated Power Supply]

Parts:
C11, C12, C13, C14, C15, C17, C18, C19, C20, C21, C22: 10uF; C_0805_2012Metric_Pad1.15x1.40mm_HandSolder; Farnell Code 2611943
C16: 10000pF; C_0805_2012Metric_Pad1.15x1.40mm_HandSolder; Farnell Code 9406352
R10, R11: 1K 1%; R_0805_2012Metric_Pad1.15x1.40mm_HandSolder; Farnell Code 2447587
R12, R13: 10K 1%; R_0805_2012Metric_Pad1.15x1.40mm_HandSolder; Farnell Code 2694096
R14: 3K3; R_0805_2012Metric_Pad1.15x1.40mm_HandSolder; Farnell Code 1469911
R15: 100; R_0805_2012Metric_Pad1.15x1.40mm_HandSolder; Farnell Code 2447552
R16, R17: 10K; R_0805_2012Metric_Pad1.15x1.40mm_HandSolder; Farnell Code 2694096
R18: 15m 1%; R_0805_2012Metric_Pad1.15x1.40mm_HandSolder; Digikey code P19200CT-ND
R19: 15m 1%; R_0805_2012Metric_Pad1.15x1.40mm_HandSolder; Digikey Code P19200CT-ND
U3, U4: LT3081_TO-220; TO-220F-7_P2.54x3.7mm_StaggerOdd_Lead3.5mm_Vertical; Digikey Code LT3081ET7#PBF-ND

Connections:
/Current Source/CSout: R18.1, R19.1; also elsewhere on the board
/ICTRL+: C18.1, C20.1, C22.1, R14.1, R17.1, R19.2, U4.4 (OUT); also elsewhere on the board
/ICTRL-: R14.2, R15.1; also elsewhere on the board
/IMON: R10.1, R11.1, U3.3 (Imon), U4.3 (Imon); also elsewhere on the board
/Linear Regulator 1/REGin: C11.1, C12.1, C13.1, C14.1, C15.1, U3.6 (IN), U4.6 (IN); also elsewhere on the board
/ON-OFF: C16.1, U3.2 (SET), U4.2 (SET); also elsewhere on the board
/T1OUT: R13.1, U4.5 (TEMP); also elsewhere on the board
/T2OUT: R12.1, U3.5 (TEMP); also elsewhere on the board
GNDS: C11.2, C12.2, C13.2, C14.2, C15.2, C16.2, C17.2, C18.2, C19.2, C20.2, C21.2, C22.2, R10.2, R11.2, R12.2, R13.2, R16.2, R17.2; also elsewhere on the board
unnamed: C17.1, C19.1, C21.1, R16.1, R18.2, U3.4 (OUT)
unnamed: R15.2, U3.1 (Ilim), U4.1 (Ilim)

Notes on the sheet:
Current regulator providing up to 3A (2 x 1.5A) controlled by a potentiometer.

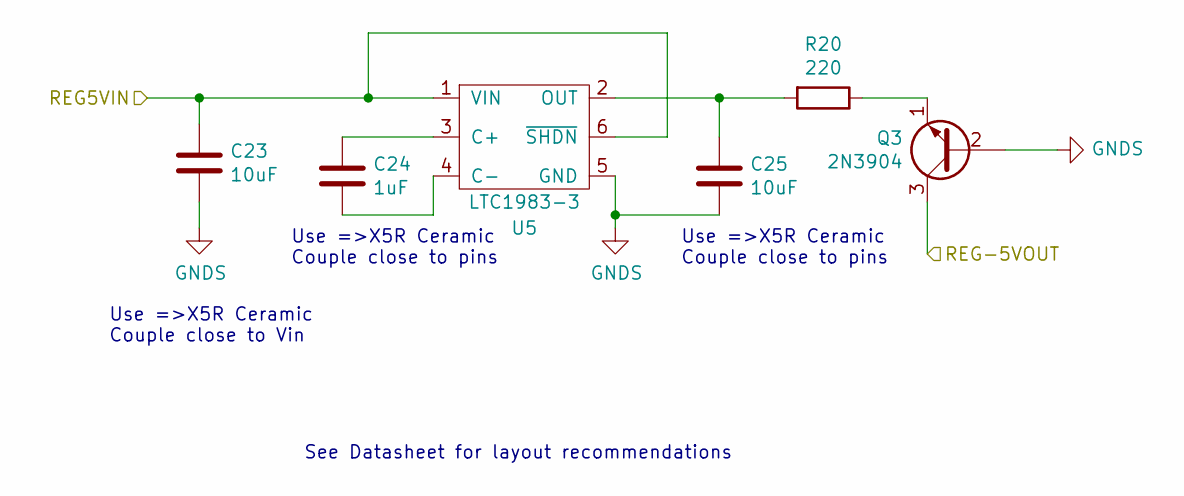
[picture p5: schematic NegPowerSupply.sch, YAPS - Regulated Power Supply]

Parts:
C23, C25: 10uF; C_0805_2012Metric_Pad1.15x1.40mm_HandSolder; Farnell Code 2611943
C24: 1uF; C_0805_2012Metric_Pad1.15x1.40mm_HandSolder; Farnell Code 2688485
Q3: 2N3904; TO-92_Inline; Farnell Code 1700648
R20: 220; R_0805_2012Metric_Pad1.15x1.40mm_HandSolder; Farnell Code 2447606
U5: LTC1983-3; TSOT-23-6_HandSoldering; Digikey Code LTC1983ES6-3#TRPBFCT-ND

Connections:
/Current Source/CSout: Q3.3 (C); also elsewhere on the board
/REG5V: C23.1, U5.1 (VIN), U5.6 (~SHDN); also elsewhere on the board
GNDS: C23.2, C25.2, Q3.2 (B), U5.5 (GND); also elsewhere on the board
unnamed: C24.1, U5.3 (C+)
unnamed: C24.2, U5.4 (C-)
unnamed: C25.1, R20.2, U5.2 (OUT)
unnamed: Q3.1 (E), R20.1

Notes on the sheet:
Use =>X5R Ceramic Couple close to pins
Use =>X5R Ceramic Couple close to Vin
See Datasheet for layout recommendations

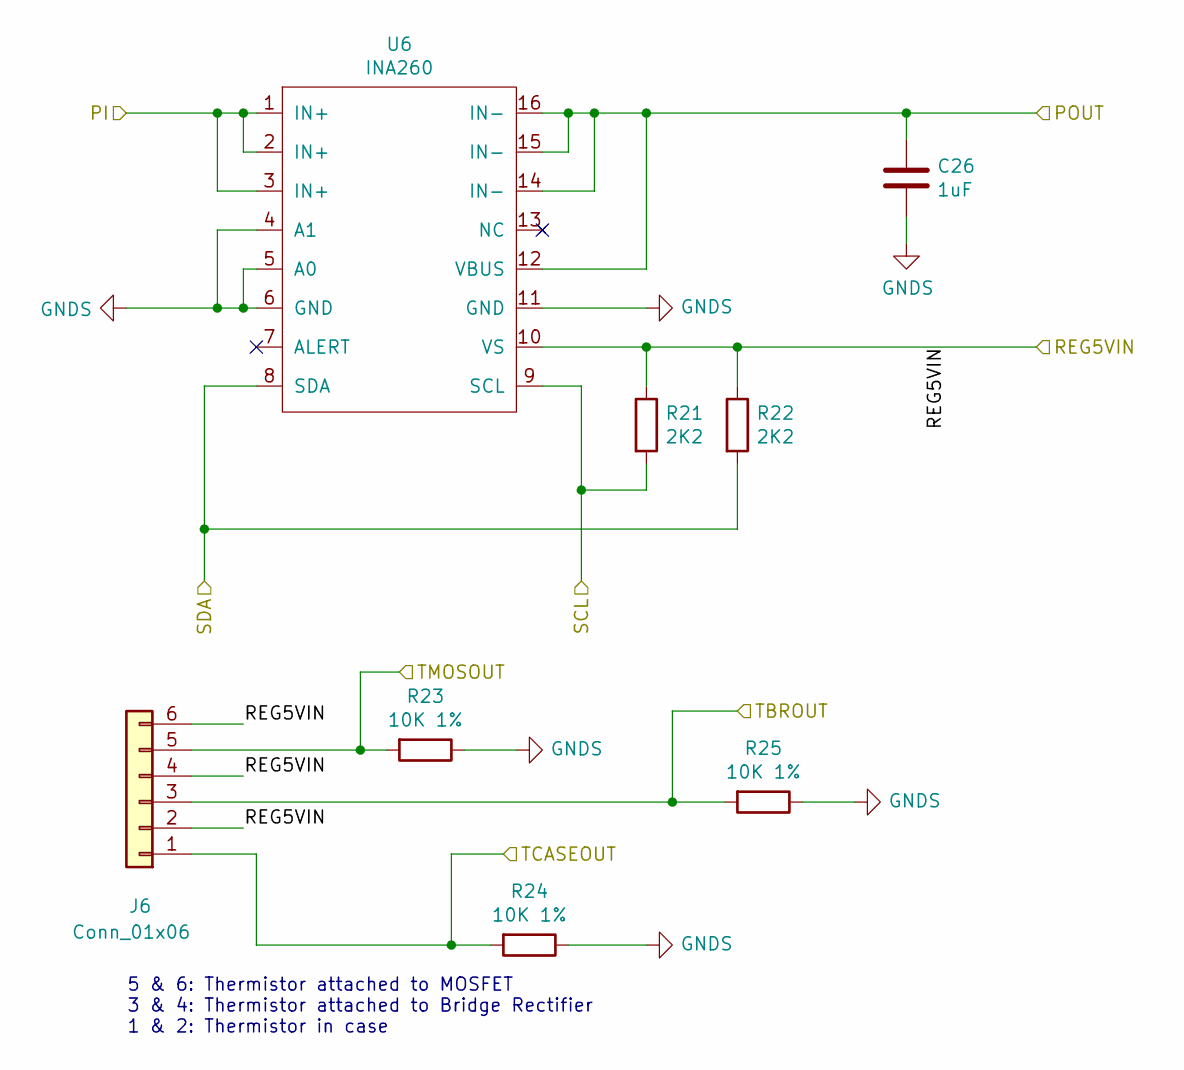
[picture p6: schematic Output_Monitor.sch, YAPS - Regulated Power Supply]

Parts:
C26: 1uF; C_0805_2012Metric_Pad1.15x1.40mm_HandSolder; Farnell Code 2688485
J6: Conn_01x06; Molex_KK-254_AE-6410-06A_1x06_P2.54mm_Vertical; Digikey Code WM4115-ND + WM1579-ND + WM2623-ND
R21, R22: 2K2; R_0805_2012Metric_Pad1.15x1.40mm_HandSolder
R23, R24, R25: 10K 1%; R_0805_2012Metric_Pad1.15x1.40mm_HandSolder; Farnell Code 2694096
U6: INA260; TSSOP-16_4.4x5mm_P0.65mm; Digikey Code 296-47777-1-ND

Connections:
/Current Source/CSout: U6.1 (IN+), U6.2 (IN+), U6.3 (IN+); also elsewhere on the board
/Output Monitoring/POUT: C26.1, U6.12 (VBUS), U6.14 (IN-), U6.15 (IN-), U6.16 (IN-); also elsewhere on the board
/REG5V: J6.2, J6.4, J6.6, R21.1, R22.1, U6.10 (VS); also elsewhere on the board
/SCL: R21.2, U6.9 (SCL); also elsewhere on the board
/SDA: R22.2, U6.8 (SDA); also elsewhere on the board
/TBROUT: J6.3, R25.2; also elsewhere on the board
/TCASEOUT: J6.1, R24.2; also elsewhere on the board
/TMOSOUT: J6.5, R23.2; also elsewhere on the board
GNDS: C26.2, R23.1, R24.1, R25.1, U6.4 (A1), U6.5 (A0), U6.6 (GND), U6.11 (GND); also elsewhere on the board

Notes on the sheet:
5 & 6: Thermistor attached to MOSFET 3 & 4: Thermistor attached to Bridge Rectifier 1 & 2: Thermistor in case

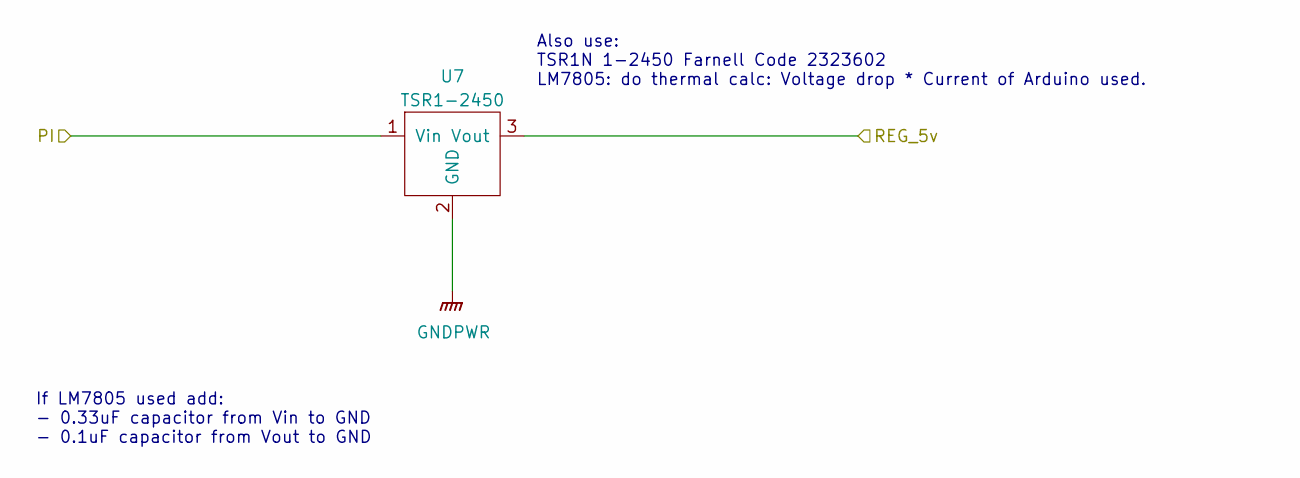
[picture p7: schematic LowVoltageSupply.sch, YAPS - Regulated Power Supply]

Parts:
U7: TSR1-2450; TSR1-24xx_TO-220-3

Connections:
/REG5V: U7.3 (Vout); also elsewhere on the board
GNDPWR: U7.2 (GND); also elsewhere on the board
VCC: U7.1 (Vin); also elsewhere on the board

Notes on the sheet:
Also use: TSR1N 1-2450 Farnell Code 2323602 LM7805: do thermal calc: Voltage drop * Current of Arduino used.
If LM7805 used add: - 0.33uF capacitor from Vin to GND - 0.1uF capacitor from Vout to GND

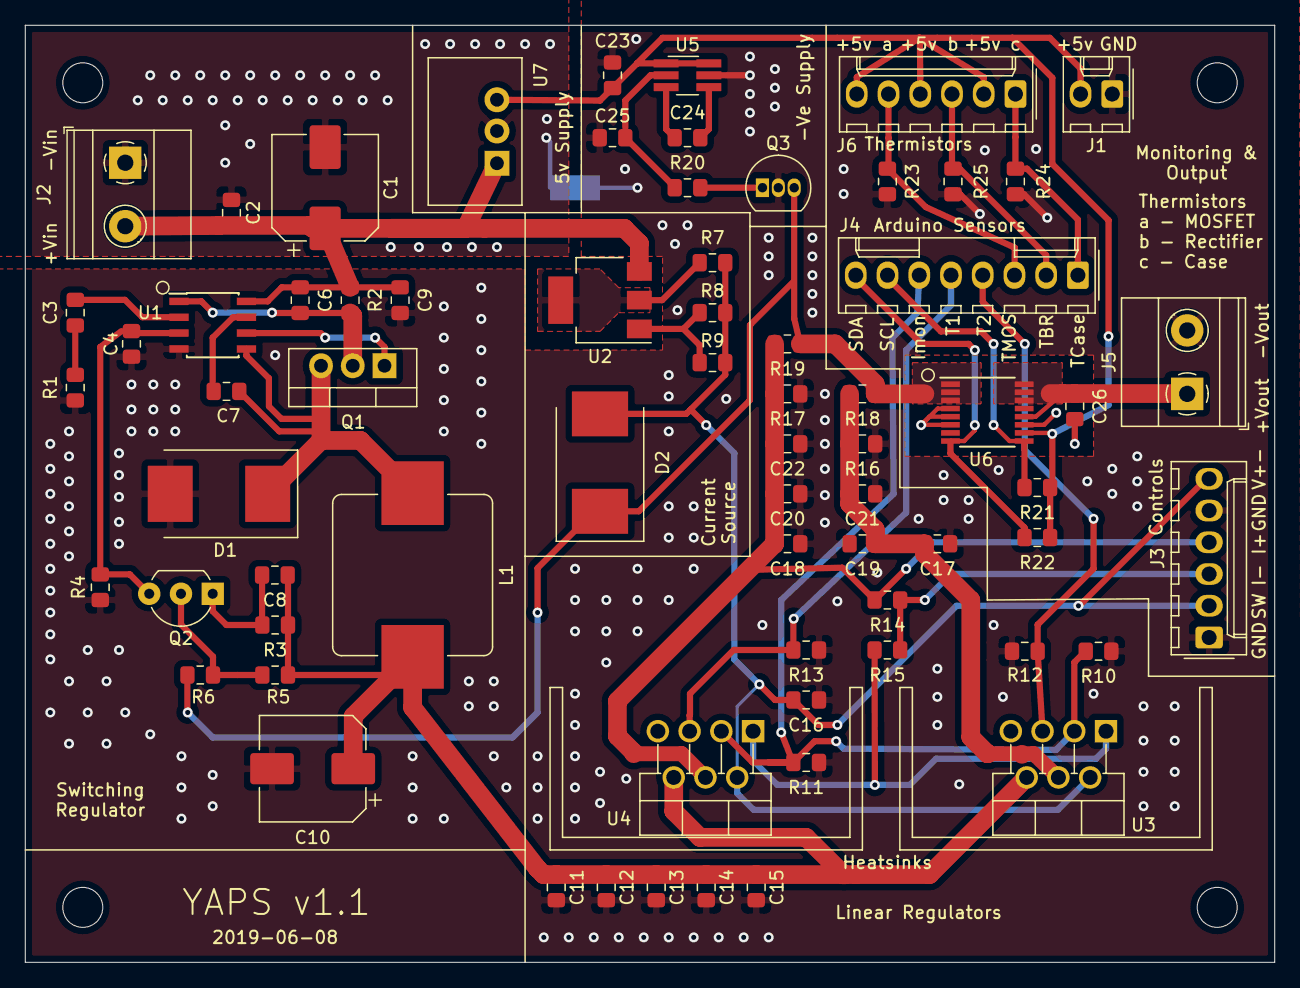
[picture p8: board PowerSupply.kicad_pcb from above]

Board: 2 copper layers, 100.0 x 75.0 mm, 70 parts (1 on the bottom side), 35 nets.
