ad-johnson/YAPS/Design/PowerStage/PowerStage.kicad_pcb

## KiCad design Design/PowerStage/PowerStage.kicad_pcb (2019-06-09)

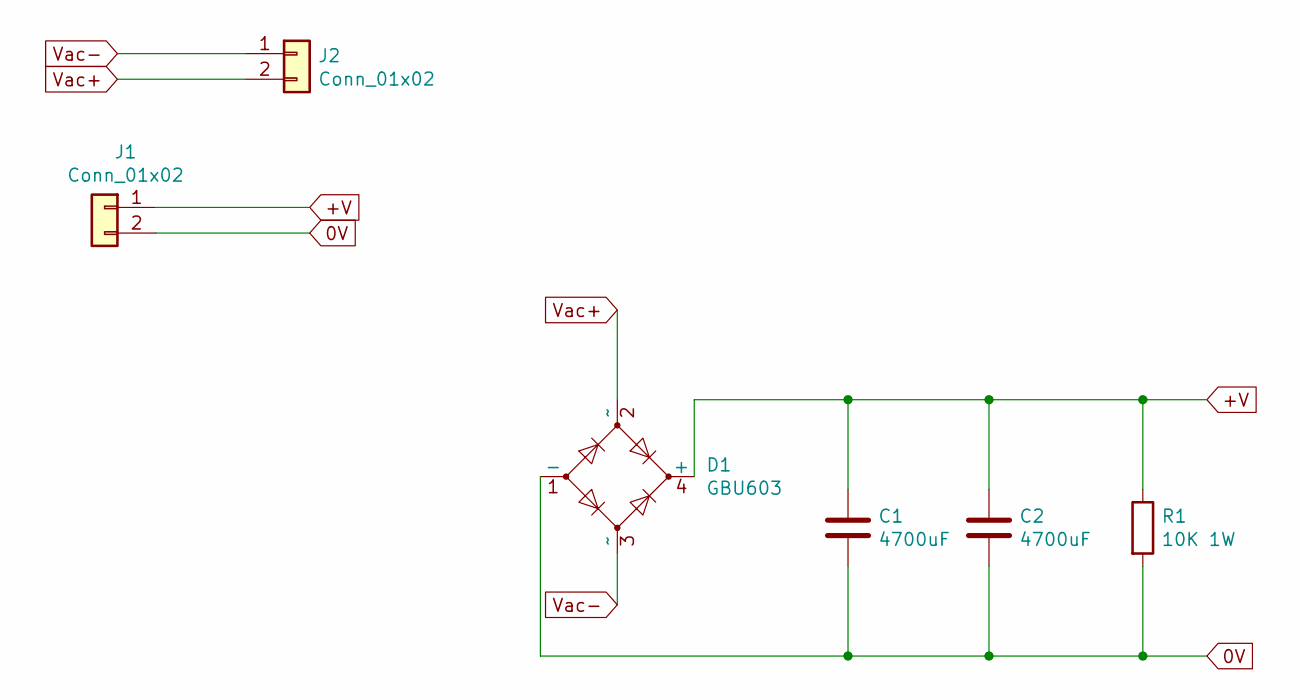
[picture p9: schematic PowerStage.sch, YAPS Power Stage]

Parts:
C1, C2: 4700uF; CP_Radial_D30.0mm_P10.00mm_SnapIn
D1: GBU603; Diode_Bridge_23.0x3.5mm_P5.0mm
J1, J2: Conn_01x02; TerminalBlock_Phoenix_MKDS-1,5-2-5.08_1x02_P5.08mm_Horizont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
R1: 10K 1W; R_Axial_DIN0207_L6.3mm_D2.5mm_P10.16mm_Horizontal

Connections:
0V: C1.2, C2.2, D1.1 (-), J1.2, R1.2
+V: C1.1, C2.1, D1.4 (+), J1.1, R1.1
Vac+: D1.2 (~~), J2.2
Vac-: D1.3 (~~), J2.1

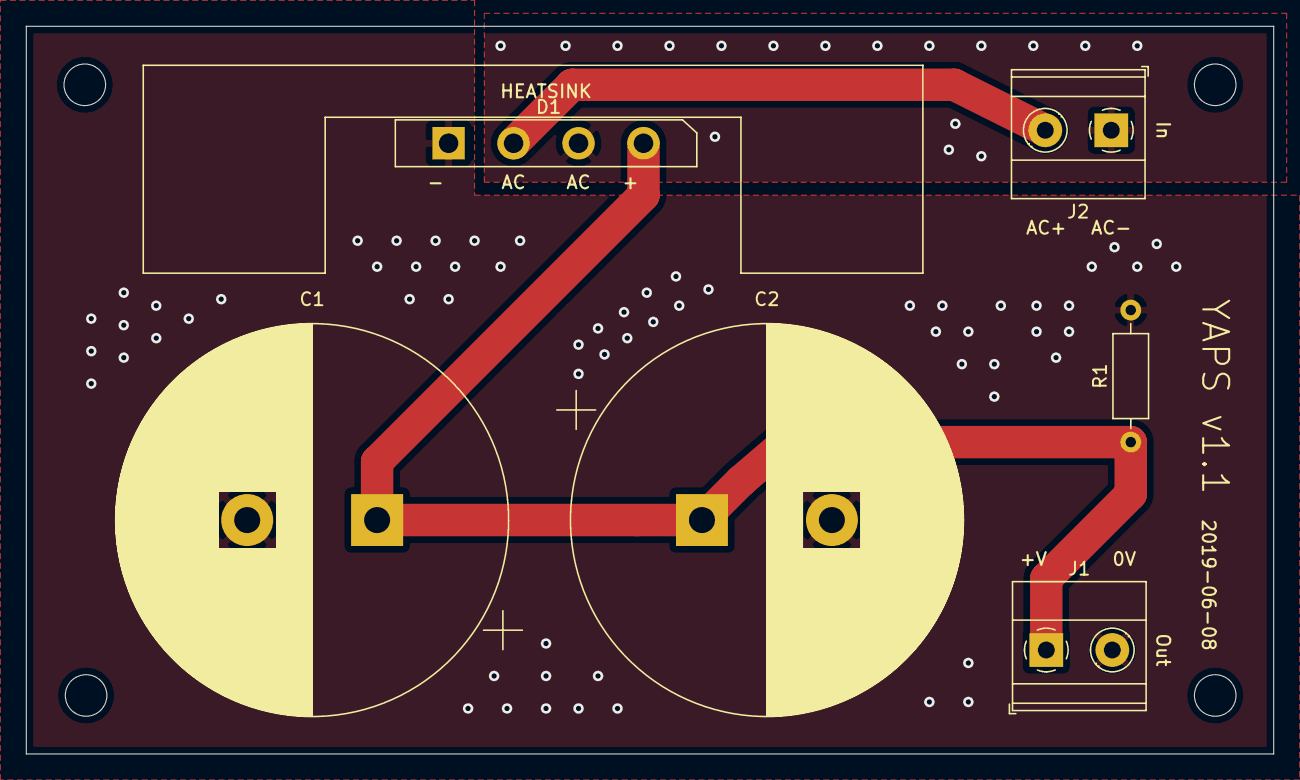
[picture p10: board PowerStage.kicad_pcb from above]

Board: 2 copper layers, 96.0 x 56.0 mm, 6 parts (0 on the bottom side), 4 nets.
