ad-johnson/YAPS/(commit log)

2019-05-28 Add files via upload
    KiCad 5 schematics
    [CurrentSource.sch, LinearRegulator.sch, LowVoltageSupply.sch, NegPowerSupply.sch, Output_Monitor.sch, PowerStage.kicad_pcb, PowerStage.sch, PowerSupply.kicad_pcb]
2019-05-28 Add files via upload
    Custom symbols and footprints. Will need to be added to paths to open schematics and PCBNew
